rgalland/PC-Engine_SuperGrafx_Schematics/README.md

# PC-Engine_SuperGrafx_Schematics
PC-Engine SuperGrafx Schematics - Reversed Enginnered from actual PCB
