rgalland/PC-Engine_SuperGrafx_Schematics/Output/0.1/SuperGrafx_Schematics.pdf

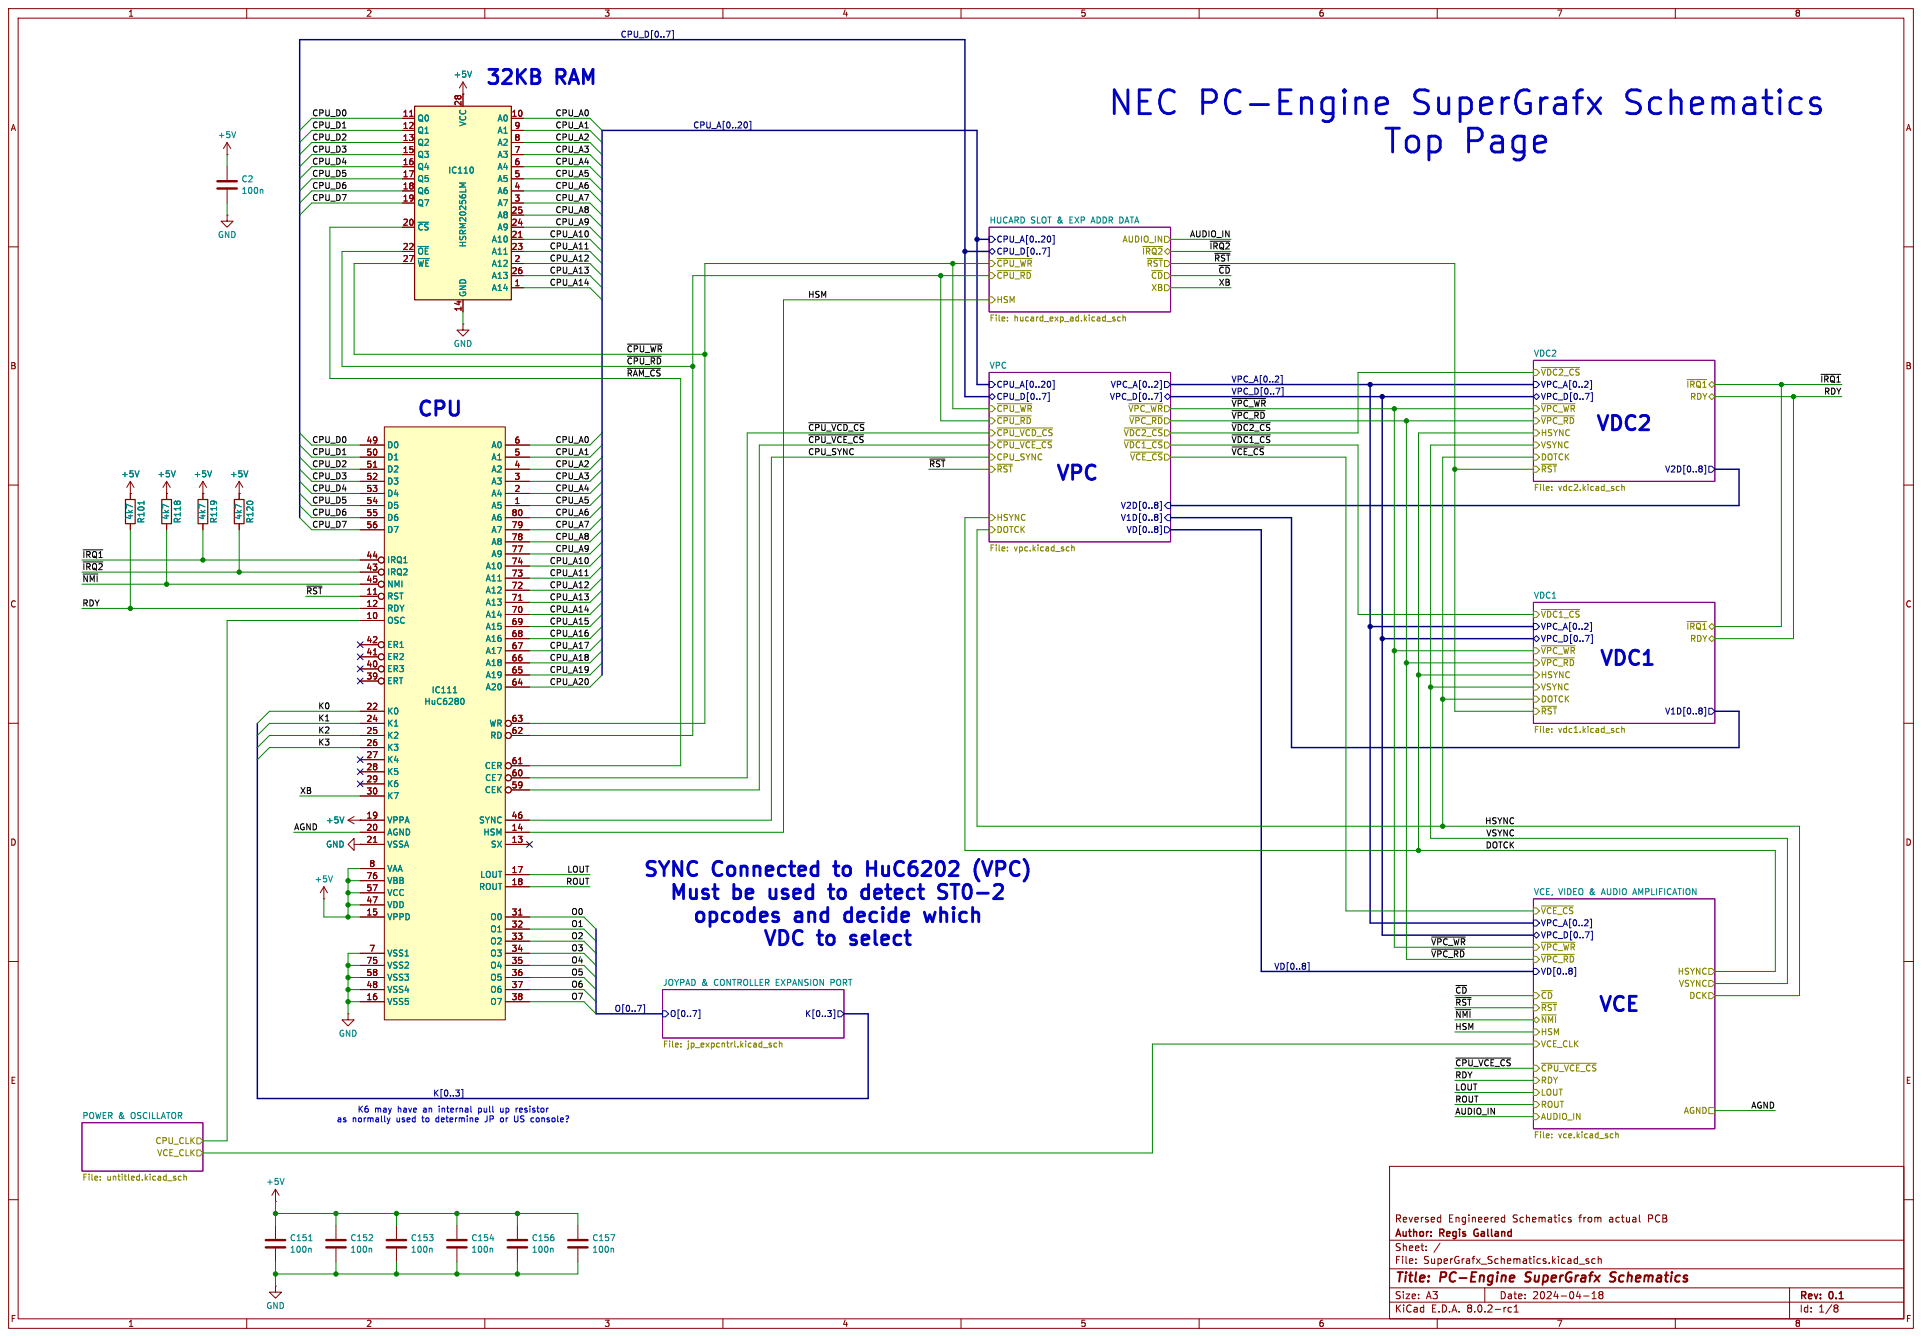
[picture p1: page 1]

~{CD} XB HUCARD SLOT & EXP ADDR DATA

SYNC Connected to HuC6202 (VPC)
Must be used to detect ST0-2
opcodes and decide which
VDC to select

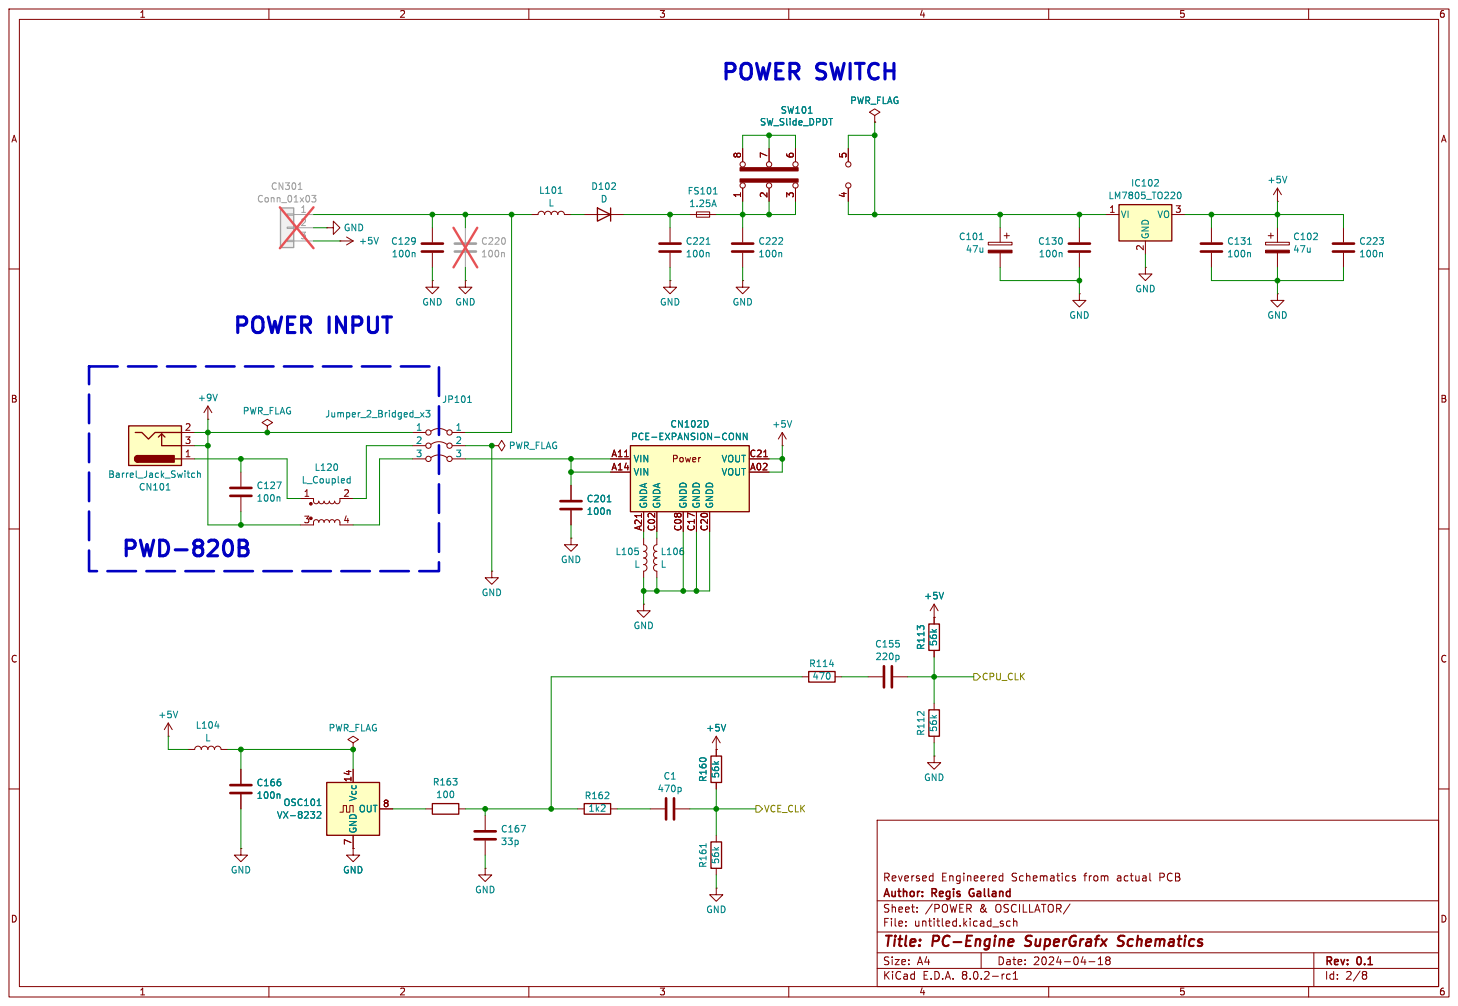
[picture p2: page 2]

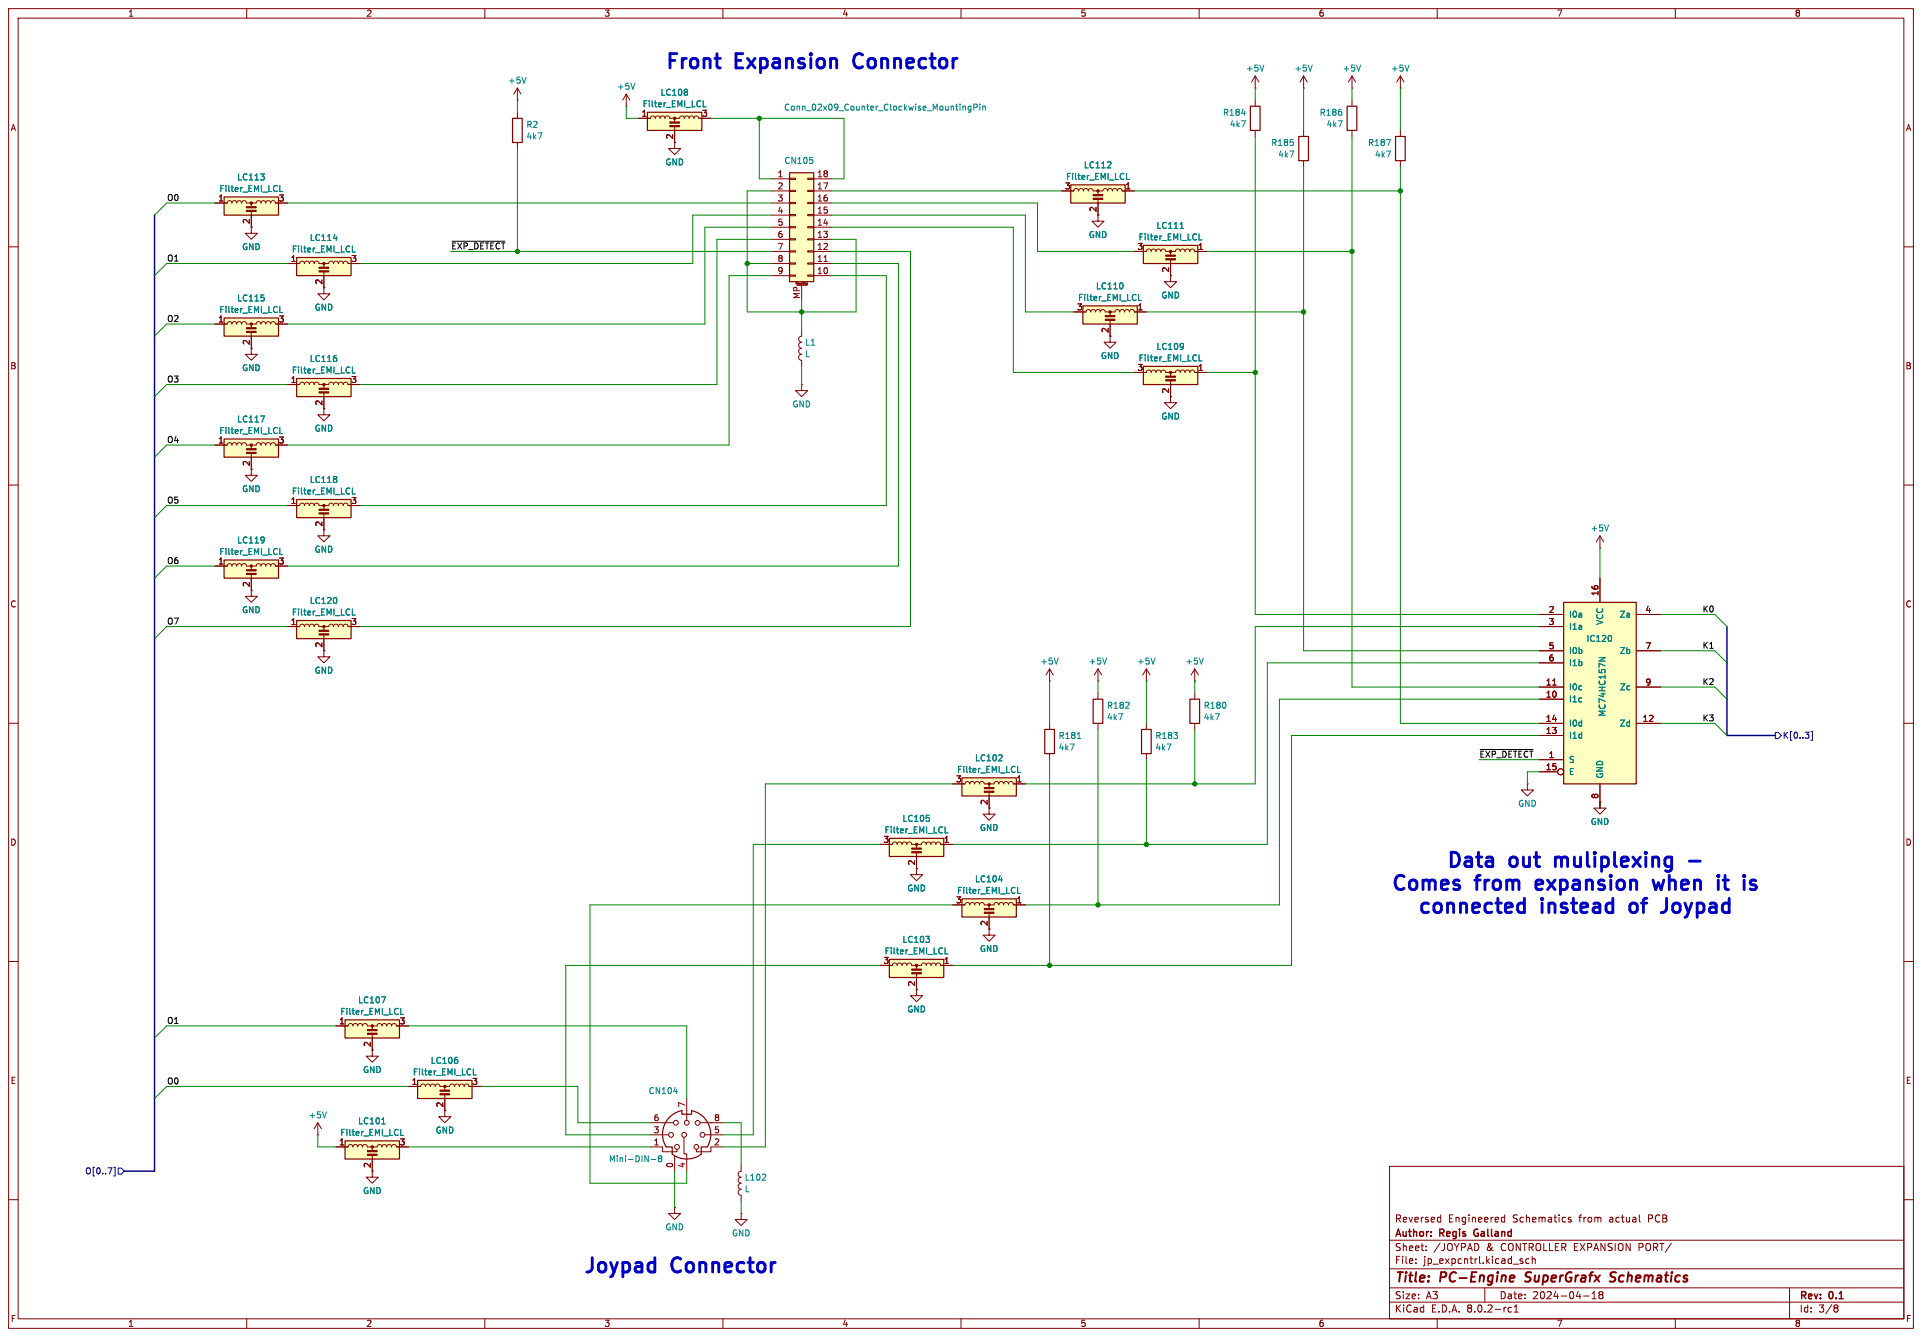
[picture p3: page 3]

8 Zc 9 GND GND GND

connected instead of Joypad

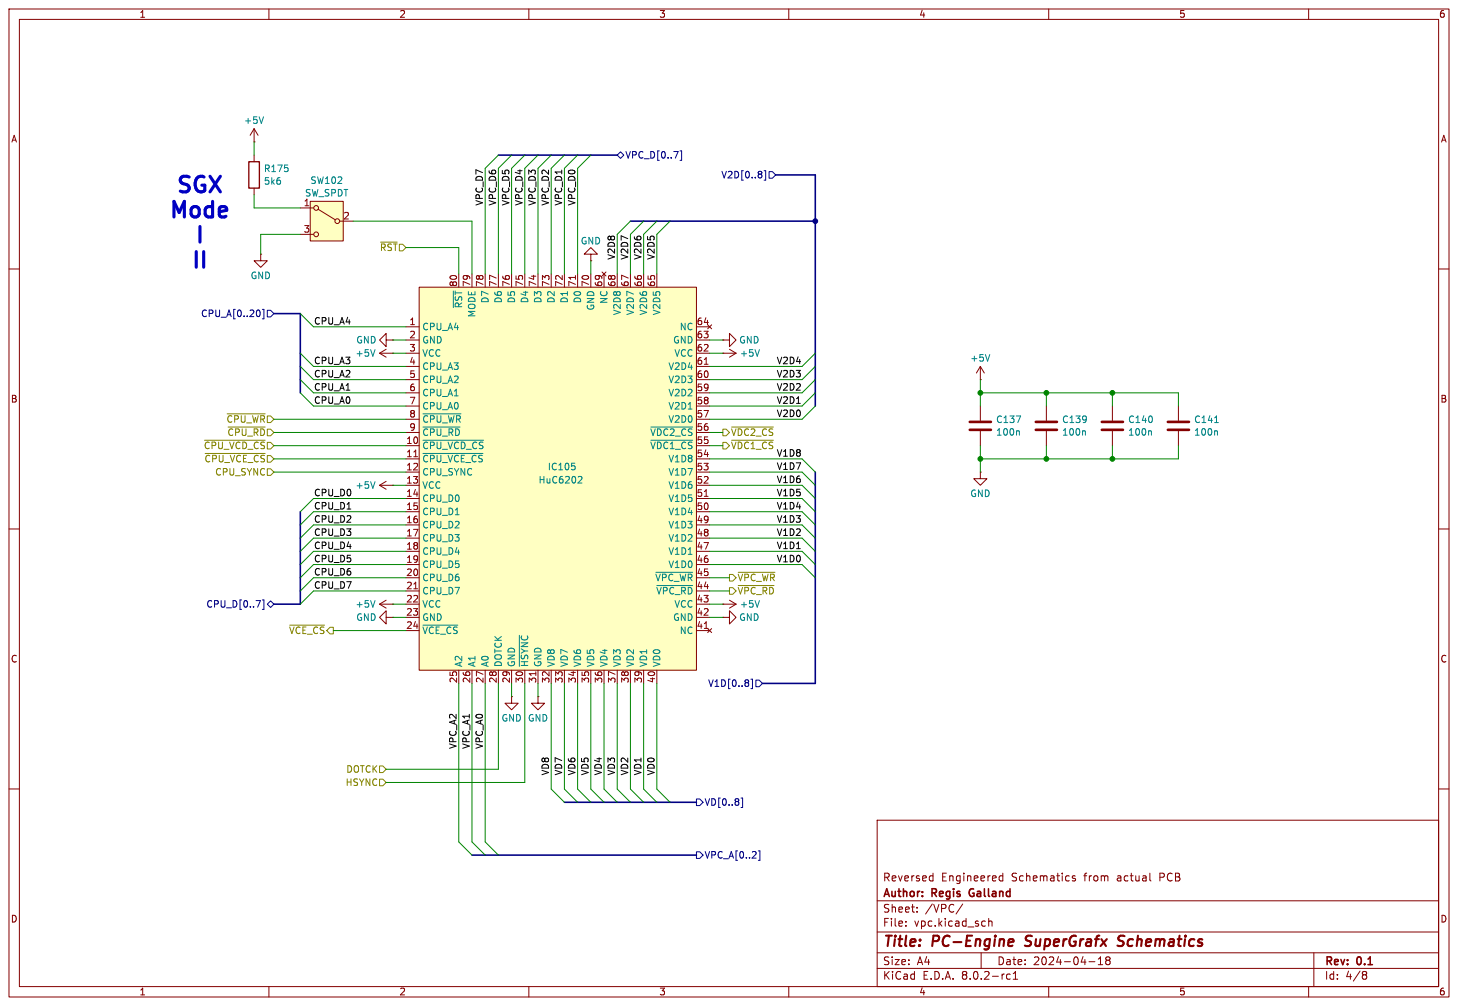
[picture p4: page 4]

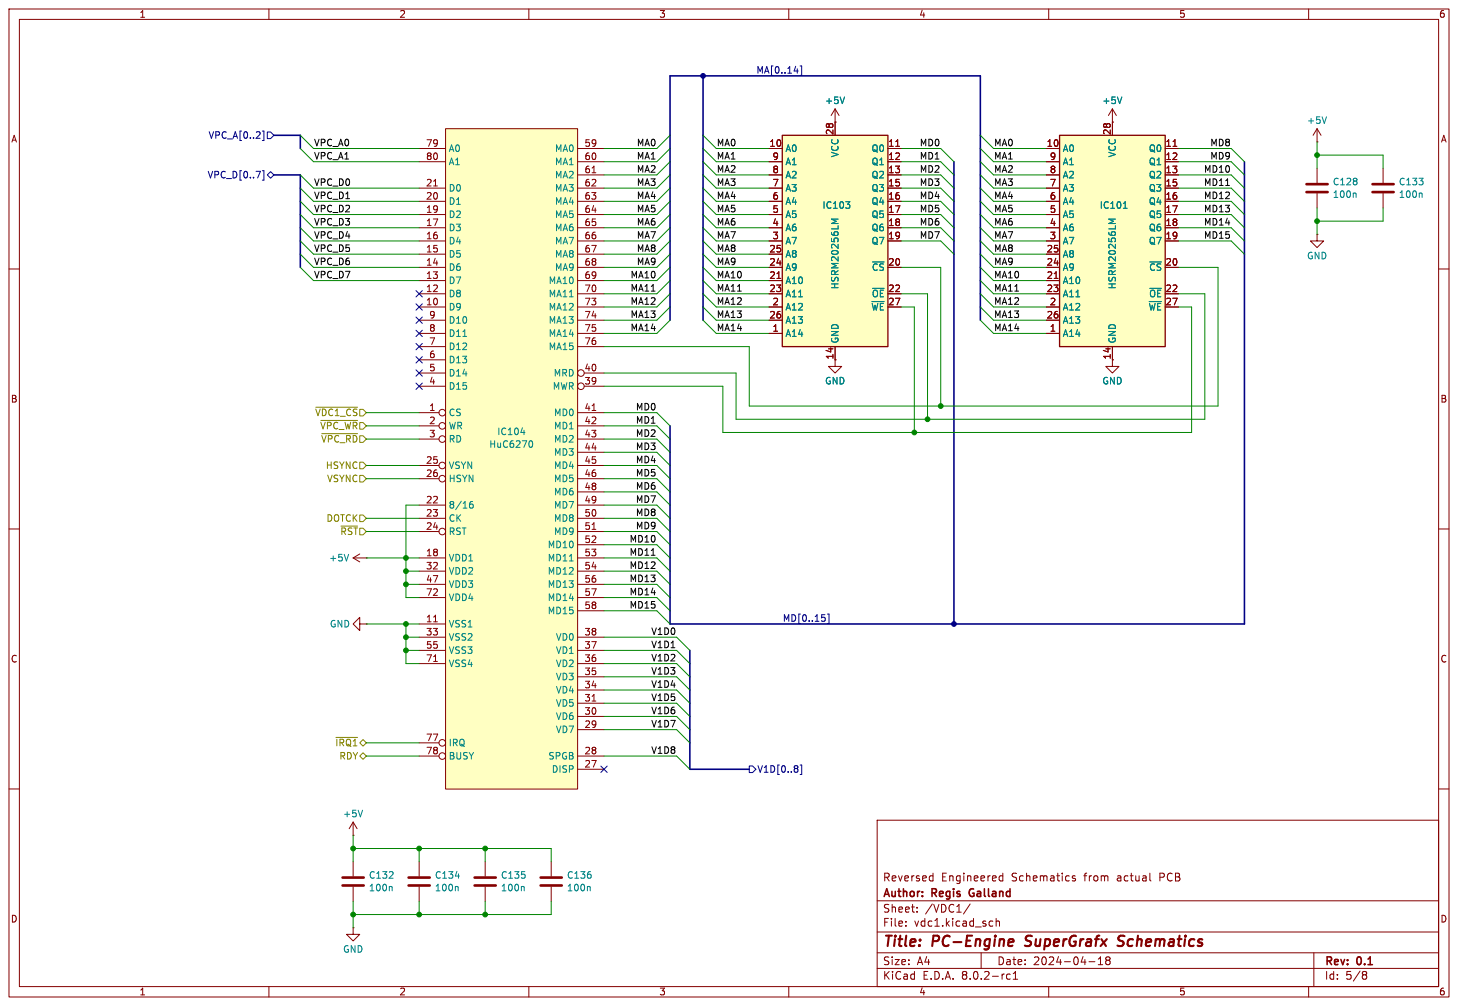
[picture p5: page 5]

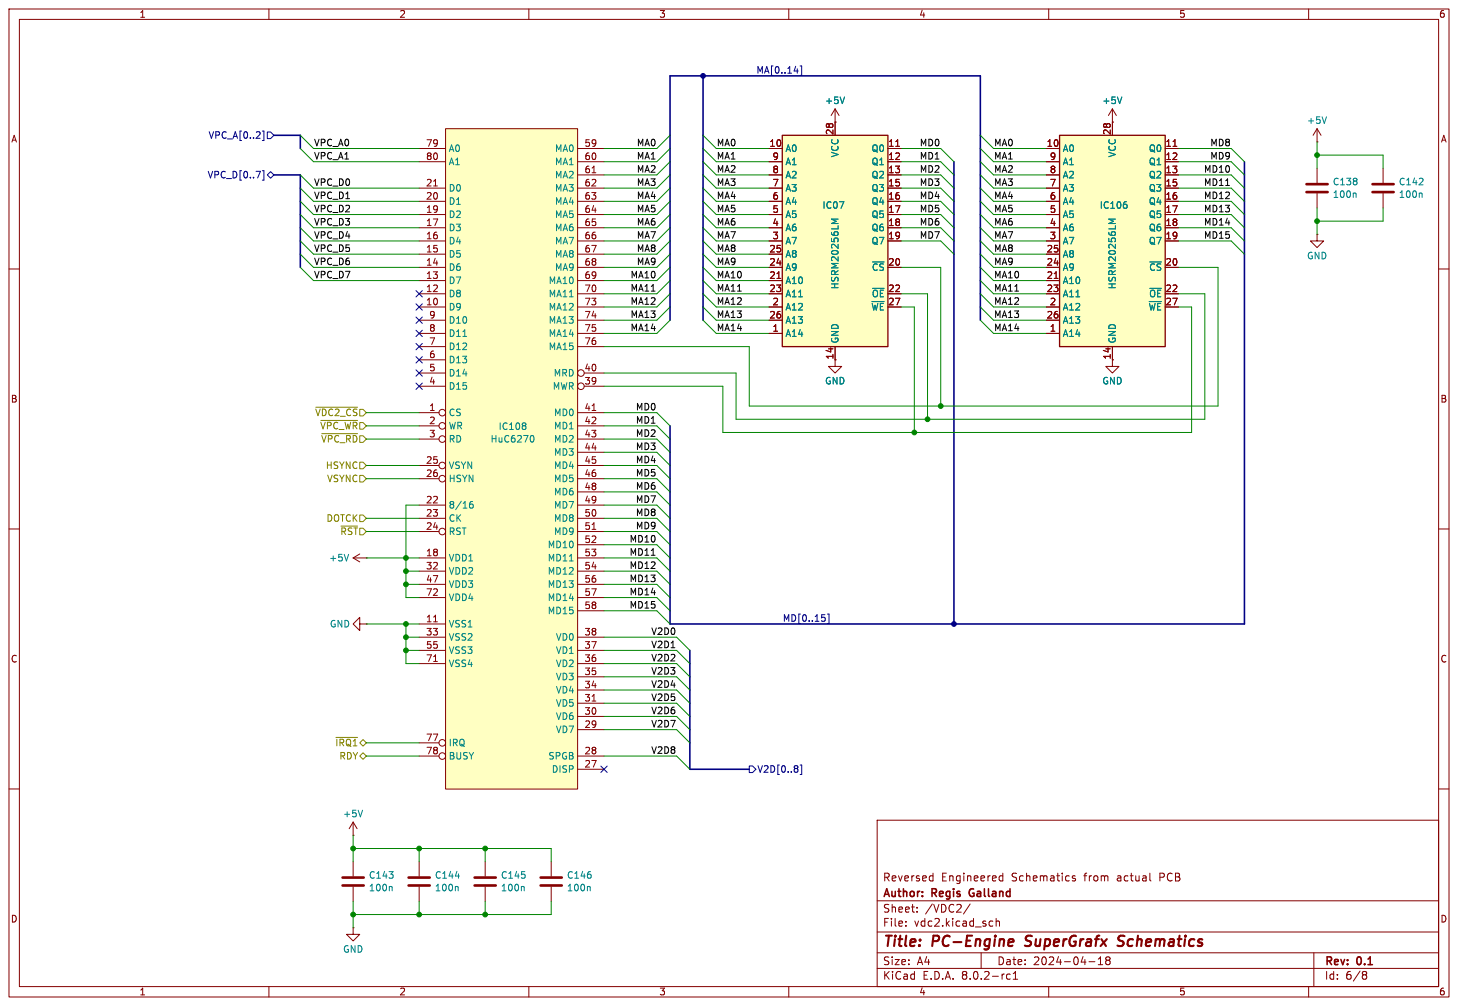
[picture p6: page 6]

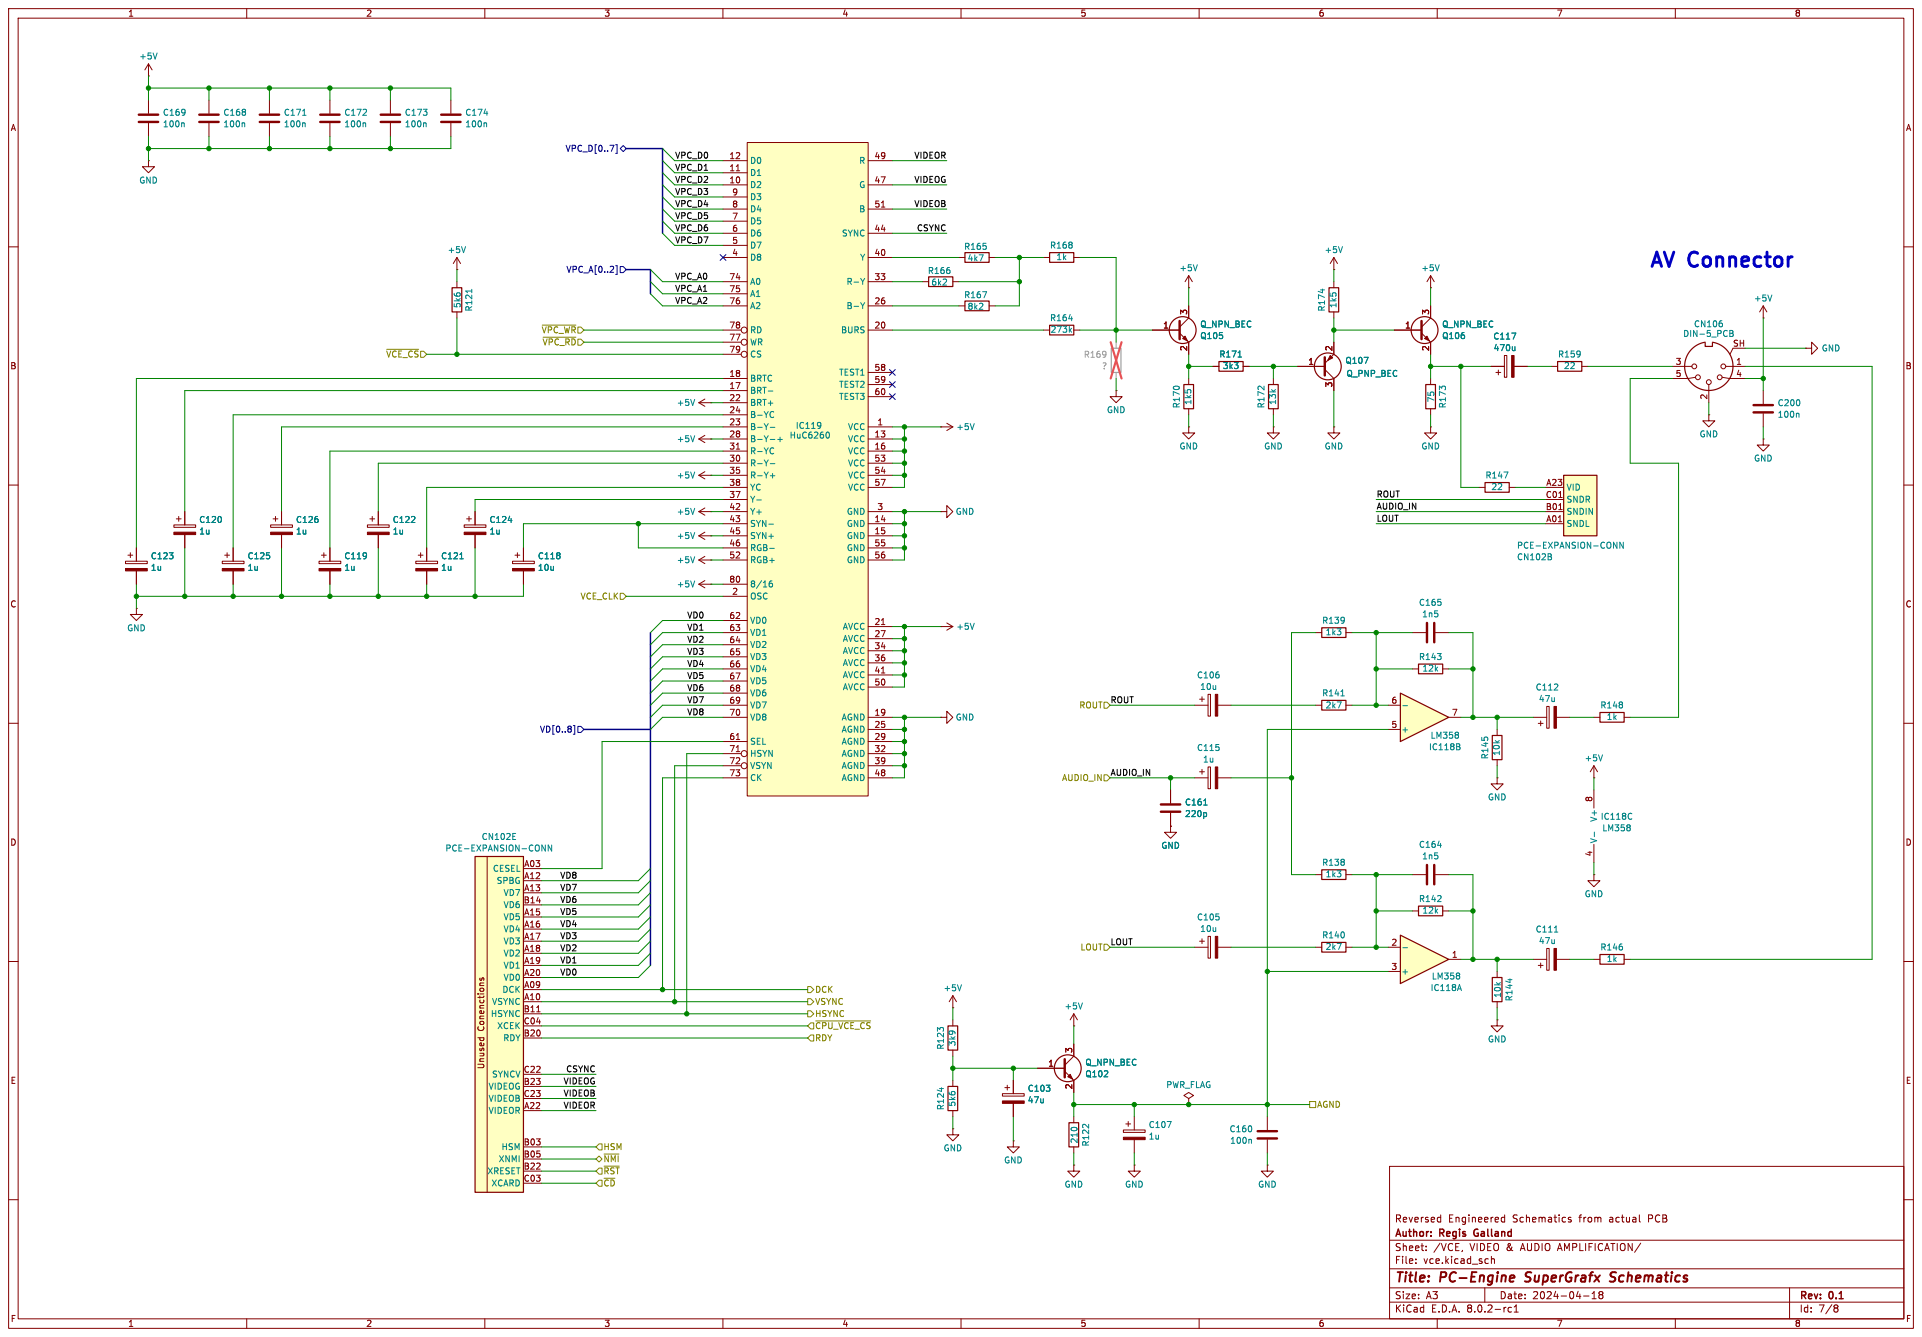
[picture p7: page 7]

1k SNDL A01 VID A23 SNDIN B01 SNDR C01 CN102B

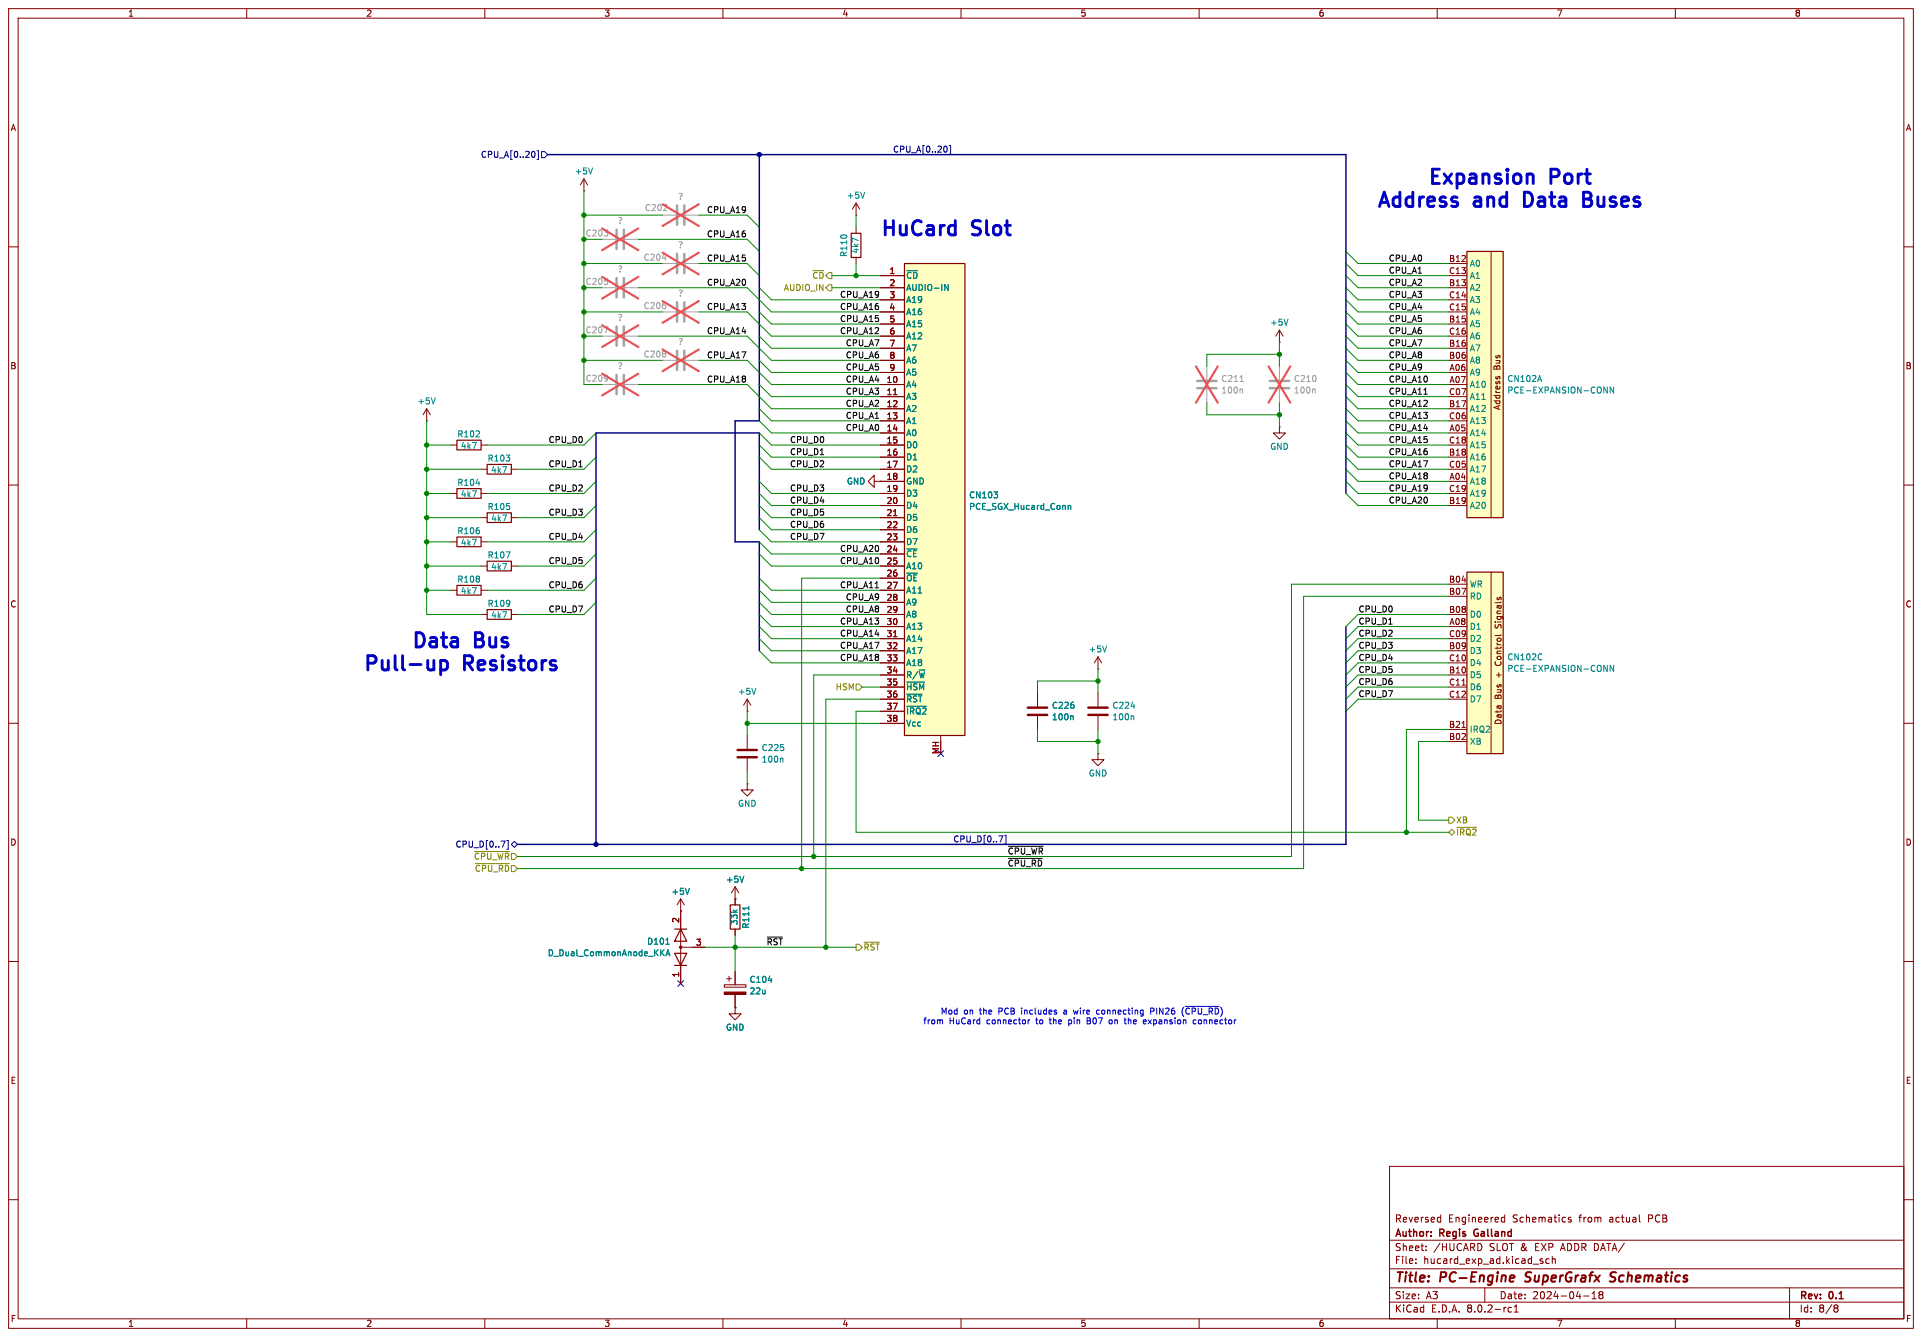
[picture p8: page 8]

PCE-EXPANSION-CONN Data Bus + Control Signals D1 A08 XB B02 WR B04 RD B07 D0 B08 D3 B09 D5 B10

Expansion Port
Address and Data Buses
