rgalland/PC-Engine_SuperGrafx_Schematics/SuperGrafx_Schematics.kicad_pcb

## KiCad design SuperGrafx_Schematics.kicad_pcb (2024-04-18)

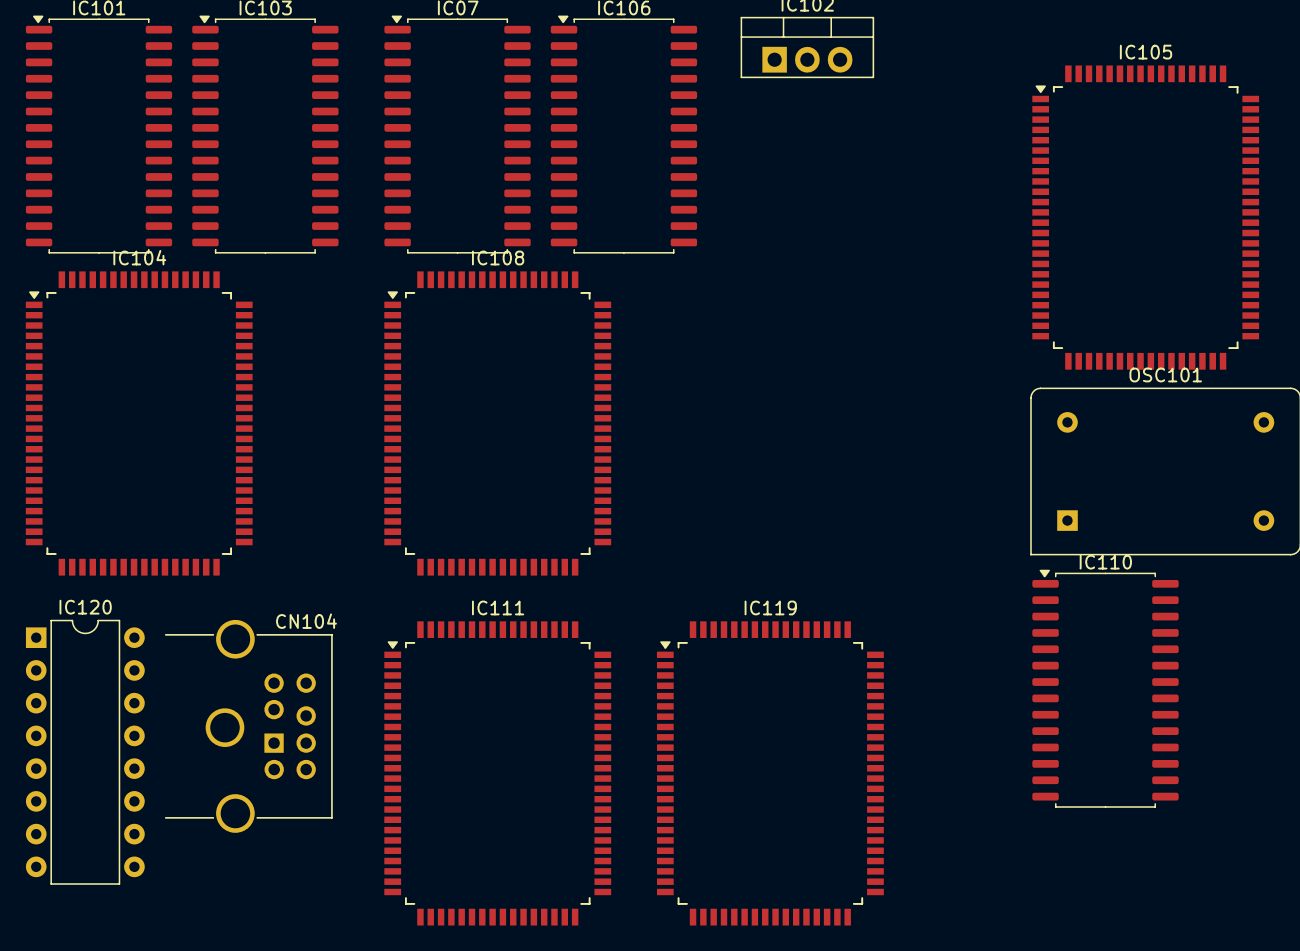
[picture p9: board SuperGrafx_Schematics.kicad_pcb from above]

Board: 2 copper layers, 14 parts (0 on the bottom side), 153 nets, no tracks yet.

Parts:
CN104: Mini-DIN-8; 1658998-1
IC07, IC101, IC103, IC106, IC110: HSRM20256LM; SOIC-28W_7.5x17.9mm_P1.27mm
IC102: LM7805_TO220; TO-220-3_Vertical
IC104, IC108: HuC6270; PQFP-80_14x20mm_P0.8mm
IC105: HuC6202; PQFP-80_14x20mm_P0.8mm
IC111: HuC6280; PQFP-80_14x20mm_P0.8mm
IC119: HuC6260; PQFP-80_14x20mm_P0.8mm
IC120: MC74HC157N; CERDIP-16_W7.62mm_SideBrazed
OSC101: VX-8232; Oscillator_DIP-14

Connections:
+5V: IC07.28 (VCC), IC101.28 (VCC), IC102.3 (VO), IC103.28 (VCC), IC104.18 (VDD1), IC104.22 (8/16), IC104.32 (VDD2), IC104.47 (VDD3), IC104.72 (VDD4), IC105.3 (VCC), IC105.13 (VCC), IC105.22 (VCC), IC105.43 (VCC), IC105.62 (VCC), IC106.28 (VCC), IC108.18 (VDD1), IC108.22 (8/16), IC108.32 (VDD2), IC108.47 (VDD3), IC108.72 (VDD4), IC110.28 (VCC), IC111.8 (VAA), IC111.15 (VPPD), IC111.19 (VPPA), IC111.47 (VDD), IC111.57 (VCC), IC111.76 (VBB), IC119.1 (VCC), IC119.13 (VCC), IC119.16 (VCC), IC119.21 (AVCC), IC119.22 (BRT+), IC119.27 (AVCC), IC119.28 (B-Y-+), IC119.34 (AVCC), IC119.35 (R-Y+), IC119.36 (AVCC), IC119.41 (AVCC), IC119.42 (Y+), IC119.45 (SYN+), IC119.50 (AVCC), IC119.52 (RGB+), IC119.53 (VCC), IC119.54 (VCC), IC119.57 (VCC), IC119.80 (8/16), IC120.16 (VCC)
/CPU_A0: IC105.7 (CPU_A0), IC110.10 (A0), IC111.6 (A0)
/CPU_A1: IC105.6 (CPU_A1), IC110.9 (A1), IC111.5 (A1)
/CPU_A2: IC105.5 (CPU_A2), IC110.8 (A2), IC111.4 (A2)
/CPU_A3: IC105.4 (CPU_A3), IC110.7 (A3), IC111.3 (A3)
/CPU_A4: IC105.1 (CPU_A4), IC110.6 (A4), IC111.2 (A4)
/CPU_A5: IC110.5 (A5), IC111.1 (A5)
/CPU_A6: IC110.4 (A6), IC111.80 (A6)
/CPU_A7: IC110.3 (A7), IC111.79 (A7)
/CPU_A8: IC110.25 (A8), IC111.78 (A8)
/CPU_A9: IC110.24 (A9), IC111.77 (A9)
/CPU_A10: IC110.21 (A10), IC111.74 (A10)
/CPU_A11: IC110.23 (A11), IC111.73 (A11)
/CPU_A12: IC110.2 (A12), IC111.72 (A12)
/CPU_A13: IC110.26 (A13), IC111.71 (A13)
/CPU_A14: IC110.1 (A14), IC111.70 (A14)
/CPU_D0: IC105.14 (CPU_D0), IC110.11 (Q0), IC111.49 (D0)
/CPU_D1: IC105.15 (CPU_D1), IC110.12 (Q1), IC111.50 (D1)
/CPU_D2: IC105.16 (CPU_D2), IC110.13 (Q2), IC111.51 (D2)
/CPU_D3: IC105.17 (CPU_D3), IC110.15 (Q3), IC111.52 (D3)
/CPU_D4: IC105.18 (CPU_D4), IC110.16 (Q4), IC111.53 (D4)
/CPU_D5: IC105.19 (CPU_D5), IC110.17 (Q5), IC111.54 (D5)
/CPU_D6: IC105.20 (CPU_D6), IC110.18 (Q6), IC111.55 (D6)
/CPU_D7: IC105.21 (CPU_D7), IC110.19 (Q7), IC111.56 (D7)
/CPU_SYNC: IC105.12 (CPU_SYNC), IC111.46 (SYNC)
/DOTCK: IC104.25 (VSYN), IC105.30 (~HSYNC), IC108.25 (VSYN), IC119.71 (HSYN)
/HSYNC: IC104.23 (CK), IC105.28 (DOTCK), IC108.23 (CK), IC119.73 (CK)
/K0: IC111.22 (K0), IC120.4 (Za)
/K1: IC111.24 (K1), IC120.7 (Zb)
/K2: IC111.25 (K2), IC120.9 (Zc)
/K3: IC111.26 (K3), IC120.12 (Zd)
/RDY: IC104.78 (BUSY), IC108.78 (BUSY), IC111.12 (RDY)
/VCE, VIDEO & AUDIO AMPLIFICATION/VD0: IC105.40 (VD0), IC119.62 (VD0)
/VCE, VIDEO & AUDIO AMPLIFICATION/VD1: IC105.39 (VD1), IC119.63 (VD1)
/VCE, VIDEO & AUDIO AMPLIFICATION/VD2: IC105.38 (VD2), IC119.64 (VD2)
/VCE, VIDEO & AUDIO AMPLIFICATION/VD3: IC105.37 (VD3), IC119.65 (VD3)
/VCE, VIDEO & AUDIO AMPLIFICATION/VD4: IC105.36 (VD4), IC119.66 (VD4)
/VCE, VIDEO & AUDIO AMPLIFICATION/VD5: IC105.35 (VD5), IC119.67 (VD5)
/VCE, VIDEO & AUDIO AMPLIFICATION/VD6: IC105.34 (VD6), IC119.68 (VD6)
/VCE, VIDEO & AUDIO AMPLIFICATION/VD7: IC105.33 (VD7), IC119.69 (VD7)
/VCE, VIDEO & AUDIO AMPLIFICATION/VD8: IC105.32 (VD8), IC119.70 (VD8)
/VDC1/MA0: IC101.10 (A0), IC103.10 (A0), IC104.59 (MA0)
/VDC1/MA1: IC101.9 (A1), IC103.9 (A1), IC104.60 (MA1)
/VDC1/MA2: IC101.8 (A2), IC103.8 (A2), IC104.61 (MA2)
/VDC1/MA3: IC101.7 (A3), IC103.7 (A3), IC104.62 (MA3)
/VDC1/MA4: IC101.6 (A4), IC103.6 (A4), IC104.63 (MA4)
/VDC1/MA5: IC101.5 (A5), IC103.5 (A5), IC104.64 (MA5)
/VDC1/MA6: IC101.4 (A6), IC103.4 (A6), IC104.65 (MA6)
/VDC1/MA7: IC101.3 (A7), IC103.3 (A7), IC104.66 (MA7)
/VDC1/MA8: IC101.25 (A8), IC103.25 (A8), IC104.67 (MA8)
/VDC1/MA9: IC101.24 (A9), IC103.24 (A9), IC104.68 (MA9)
/VDC1/MA10: IC101.21 (A10), IC103.21 (A10), IC104.69 (MA10)
/VDC1/MA11: IC101.23 (A11), IC103.23 (A11), IC104.70 (MA11)
/VDC1/MA12: IC101.2 (A12), IC103.2 (A12), IC104.73 (MA12)
/VDC1/MA13: IC101.26 (A13), IC103.26 (A13), IC104.74 (MA13)
/VDC1/MA14: IC101.1 (A14), IC103.1 (A14), IC104.75 (MA14)
/VDC1/MD0: IC103.11 (Q0), IC104.41 (MD0)
/VDC1/MD1: IC103.12 (Q1), IC104.42 (MD1)
/VDC1/MD2: IC103.13 (Q2), IC104.43 (MD2)
/VDC1/MD3: IC103.15 (Q3), IC104.44 (MD3)
/VDC1/MD4: IC103.16 (Q4), IC104.45 (MD4)
/VDC1/MD5: IC103.17 (Q5), IC104.46 (MD5)
/VDC1/MD6: IC103.18 (Q6), IC104.48 (MD6)
/VDC1/MD7: IC103.19 (Q7), IC104.49 (MD7)
/VDC1/MD8: IC101.11 (Q0), IC104.50 (MD8)
/VDC1/MD9: IC101.12 (Q1), IC104.51 (MD9)
/VDC1/MD10: IC101.13 (Q2), IC104.52 (MD10)
/VDC1/MD11: IC101.15 (Q3), IC104.53 (MD11)
/VDC1/MD12: IC101.16 (Q4), IC104.54 (MD12)
/VDC1/MD13: IC101.17 (Q5), IC104.56 (MD13)
/VDC1/MD14: IC101.18 (Q6), IC104.57 (MD14)
/VDC1/MD15: IC101.19 (Q7), IC104.58 (MD15)
/VDC1/V1D0: IC104.38 (VD0), IC105.46 (V1D0)
/VDC1/V1D1: IC104.37 (VD1), IC105.47 (V1D1)
/VDC1/V1D2: IC104.36 (VD2), IC105.48 (V1D2)
/VDC1/V1D3: IC104.35 (VD3), IC105.49 (V1D3)
/VDC1/V1D4: IC104.34 (VD4), IC105.50 (V1D4)
/VDC1/V1D5: IC104.31 (VD5), IC105.51 (V1D5)
/VDC1/V1D6: IC104.30 (VD6), IC105.52 (V1D6)
/VDC1/V1D7: IC104.29 (VD7), IC105.53 (V1D7)
/VDC1/V1D8: IC104.28 (SPGB), IC105.54 (V1D8)
/VDC2/MA0: IC07.10 (A0), IC106.10 (A0), IC108.59 (MA0)
/VDC2/MA1: IC07.9 (A1), IC106.9 (A1), IC108.60 (MA1)
/VDC2/MA2: IC07.8 (A2), IC106.8 (A2), IC108.61 (MA2)
/VDC2/MA3: IC07.7 (A3), IC106.7 (A3), IC108.62 (MA3)
/VDC2/MA4: IC07.6 (A4), IC106.6 (A4), IC108.63 (MA4)
/VDC2/MA5: IC07.5 (A5), IC106.5 (A5), IC108.64 (MA5)
/VDC2/MA6: IC07.4 (A6), IC106.4 (A6), IC108.65 (MA6)
/VDC2/MA7: IC07.3 (A7), IC106.3 (A7), IC108.66 (MA7)
/VDC2/MA8: IC07.25 (A8), IC106.25 (A8), IC108.67 (MA8)
/VDC2/MA9: IC07.24 (A9), IC106.24 (A9), IC108.68 (MA9)
/VDC2/MA10: IC07.21 (A10), IC106.21 (A10), IC108.69 (MA10)
/VDC2/MA11: IC07.23 (A11), IC106.23 (A11), IC108.70 (MA11)
/VDC2/MA12: IC07.2 (A12), IC106.2 (A12), IC108.73 (MA12)
/VDC2/MA13: IC07.26 (A13), IC106.26 (A13), IC108.74 (MA13)
/VDC2/MA14: IC07.1 (A14), IC106.1 (A14), IC108.75 (MA14)
/VDC2/MD0: IC07.11 (Q0), IC108.41 (MD0)
/VDC2/MD1: IC07.12 (Q1), IC108.42 (MD1)
/VDC2/MD2: IC07.13 (Q2), IC108.43 (MD2)
/VDC2/MD3: IC07.15 (Q3), IC108.44 (MD3)
/VDC2/MD4: IC07.16 (Q4), IC108.45 (MD4)
/VDC2/MD5: IC07.17 (Q5), IC108.46 (MD5)
/VDC2/MD6: IC07.18 (Q6), IC108.48 (MD6)
/VDC2/MD7: IC07.19 (Q7), IC108.49 (MD7)
/VDC2/MD8: IC106.11 (Q0), IC108.50 (MD8)
/VDC2/MD9: IC106.12 (Q1), IC108.51 (MD9)
/VDC2/MD10: IC106.13 (Q2), IC108.52 (MD10)
/VDC2/MD11: IC106.15 (Q3), IC108.53 (MD11)
/VDC2/MD12: IC106.16 (Q4), IC108.54 (MD12)
/VDC2/MD13: IC106.17 (Q5), IC108.56 (MD13)
/VDC2/MD14: IC106.18 (Q6), IC108.57 (MD14)
/VDC2/MD15: IC106.19 (Q7), IC108.58 (MD15)
/VDC2/V2D0: IC105.57 (V2D0), IC108.38 (VD0)
/VDC2/V2D1: IC105.58 (V2D1), IC108.37 (VD1)
/VDC2/V2D2: IC105.59 (V2D2), IC108.36 (VD2)
/VDC2/V2D3: IC105.60 (V2D3), IC108.35 (VD3)
/VDC2/V2D4: IC105.61 (V2D4), IC108.34 (VD4)
/VDC2/V2D5: IC105.65 (V2D5), IC108.31 (VD5)
/VDC2/V2D6: IC105.66 (V2D6), IC108.30 (VD6)
/VDC2/V2D7: IC105.67 (V2D7), IC108.29 (VD7)
/VDC2/V2D8: IC105.68 (V2D8), IC108.28 (SPGB)
/VPC_A0: IC104.79 (A0), IC105.27 (A0), IC108.79 (A0), IC119.74 (A0)
/VPC_A1: IC104.80 (A1), IC105.26 (A1), IC108.80 (A1), IC119.75 (A1)
/VPC_A2: IC105.25 (A2), IC119.76 (A2)
/VPC_D0: IC104.21 (D0), IC105.71 (D0), IC108.21 (D0), IC119.12 (D0)
/VPC_D1: IC104.20 (D1), IC105.72 (D1), IC108.20 (D1), IC119.11 (D1)
/VPC_D2: IC104.19 (D2), IC105.73 (D2), IC108.19 (D2), IC119.10 (D2)
/VPC_D3: IC104.17 (D3), IC105.74 (D3), IC108.17 (D3), IC119.9 (D3)
/VPC_D4: IC104.16 (D4), IC105.75 (D4), IC108.16 (D4), IC119.8 (D4)
/VPC_D5: IC104.15 (D5), IC105.76 (D5), IC108.15 (D5), IC119.7 (D5)
/VPC_D6: IC104.14 (D6), IC105.77 (D6), IC108.14 (D6), IC119.6 (D6)
/VPC_D7: IC104.13 (D7), IC105.78 (D7), IC108.13 (D7), IC119.5 (D7)
/VSYNC: IC104.26 (HSYN), IC108.26 (HSYN), IC119.72 (VSYN)
/~CPU_RD: IC105.9 (~CPU_RD), IC110.22 (~OE), IC111.62 (RD)
/~CPU_VCD_CS: IC105.10 (~CPU_VCD_CS), IC111.60 (CE7)
/~CPU_VCE_CS: IC105.11 (~CPU_VCE_CS), IC111.59 (CEK)
/~CPU_WR: IC105.8 (~CPU_WR), IC110.27 (~WE), IC111.63 (WR)
/~IRQ1: IC104.77 (IRQ), IC108.77 (IRQ), IC111.44 (IRQ1)
/~RAM_CS: IC110.20 (~CS), IC111.61 (CER)
/~RST: IC104.24 (RST), IC105.80 (~RST), IC108.24 (RST), IC111.11 (RST)
/~VCE_CS: IC105.24 (~VCE_CS), IC119.79 (CS)
/~VDC1_CS: IC104.1 (CS), IC105.55 (~VDC1_CS)
/~VDC2_CS: IC105.56 (~VDC2_CS), IC108.1 (CS)
/~VPC_RD: IC104.3 (RD), IC105.44 (~VPC_RD), IC108.3 (RD), IC119.77 (WR)
/~VPC_WR: IC104.2 (WR), IC105.45 (~VPC_WR), IC108.2 (WR), IC119.78 (RD)
GND: IC07.14 (GND), IC101.14 (GND), IC102.2 (GND), IC103.14 (GND), IC104.11 (VSS1), IC104.33 (VSS2), IC104.55 (VSS3), IC104.71 (VSS4), IC105.2 (GND), IC105.23 (GND), IC105.29 (GND), IC105.31 (GND), IC105.42 (GND), IC105.63 (GND), IC105.70 (GND), IC106.14 (GND), IC108.11 (VSS1), IC108.33 (VSS2), IC108.55 (VSS3), IC108.71 (VSS4), IC110.14 (GND), IC111.7 (VSS1), IC111.16 (VSS5), IC111.21 (VSSA), IC111.48 (VSS4), IC111.58 (VSS3), IC111.75 (VSS2), IC119.3 (GND), IC119.14 (GND), IC119.15 (GND), IC119.19 (AGND), IC119.25 (AGND), IC119.29 (AGND), IC119.32 (AGND), IC119.39 (AGND), IC119.48 (AGND), IC119.55 (GND), IC119.56 (GND), IC120.8 (GND), IC120.15 (E), OSC101.7 (GND)
unnamed: IC07.20 (~CS), IC106.20 (~CS), IC108.76 (MA15)
unnamed: IC07.22 (~OE), IC106.22 (~OE), IC108.40 (MRD)
unnamed: IC07.27 (~WE), IC106.27 (~WE), IC108.39 (MWR)
unnamed: IC101.20 (~CS), IC103.20 (~CS), IC104.76 (MA15)
unnamed: IC101.22 (~OE), IC103.22 (~OE), IC104.40 (MRD)
unnamed: IC101.27 (~WE), IC103.27 (~WE), IC104.39 (MWR)
unnamed: IC119.43 (SYN-), IC119.46 (RGB-)
